OliverMontorio/ball-and-beam-control/data/sensor_calibration.csv

physical_distance_mm | sensor_distance_mm
20 | 30
50 | 62
100 | 117.5
110 | 126
150 | 162
200 | 187.5
